Technology-for-the-Poorest-Billion/2024-ideabatic-smirk/README.md

# Project to miniaturise Smile by Ideabatic

## Introduction to project

## Initial aims of the project

## Market research

## Redefined aims of project

## Low fidelity thermal analysis

## Detailed thermal analysis

## Ice pack chamber design and prototyping

## Carousel design and prototyping

## Strap design and prototyping

## Final project deliverables
