Technology-for-the-Poorest-Billion/2024-ideabatic-smirk/interim/Market research and Product design sheets.md

We began by talking to Kitty with what she would like us to do. She got
us started on looking into the UK market, and what applications the box
would work on. We looked into the currently available options, but none
of them seemed appropriate. We asked for kittys market research, and
found that typically vaccination travel rounds last for upwards of 5
hours, which is already enough that a medic may not wish to extend this
time further.

We talked to personal connections we know to see if there would be a
smaller personal ice box market, however this also backfired, as most
people in that market would not need their medication cold dor much
longer than a few hours, and can do so with a small box when on holiday
etc.

The conclusion we came to was that the NHS market was no good. We
proposed a second market to Kitty of a third world country where the
journeys are less dangerous than those currently taken, but still
require a lot of vaccinations in one go. We then looked at current large
capacity cold boxes, and how the existing smile addresses those issues.

Market research:

<table style="width:100%;">
<colgroup>
<col style="width: 16%" />
<col style="width: 16%" />
<col style="width: 16%" />
<col style="width: 16%" />
<col style="width: 16%" />
<col style="width: 16%" />
</colgroup>
<thead>
<tr class="header">
<th>Name</th>
<th>Cold time</th>
<th>Price</th>
<th>Capacity</th>
<th>Weight</th>
<th>Notes</th>
</tr>
<tr class="odd">
<th>Versapak:</th>
<th>Up to 30 hours (assuming unopened at room temperature, not 40
degrees outside)</th>
<th><p>35L = 200 (bundle with 5x700 ice packs = 260)</p>
<p>18L = 155</p>
<p>6L = 136</p></th>
<th><p>Internal Capacity: 6 Litres</p>
<p>Weight (Empty): 1.658kg</p>
<p>Medium - 460 x 305 x 255mm</p>
<p>Internal Capacity: 18 Litres</p>
<p>Weight (Empty): 2.151kg</p>
<p>Large - 650 x 380 x 255mm</p>
<p>Internal Capacity: 35 Litres</p>
<p>Weight (Empty): 3.657kg</p></th>
<th>Ice packs 500ml-700ml per, about 5 ice packs</th>
<th><p>Quite expensive, need to look at how many vaccines can fit.</p>
<p>Too large to comfortably carry in any way other than handle, probably
not great for long walks. Current smile improves on: weight, size,
no.vaccines, cold time with only 1 ice pack.</p></th>
</tr>
<tr class="header">
<th>VaccinePorter:</th>
<th>8 hour plus time</th>
<th>£160</th>
<th>2.2L capacity</th>
<th></th>
<th></th>
</tr>
<tr class="odd">
<th><a
href="https://www.corrmed.com/product-page/porta-thermal-20-litre-vaccine-bag-bundle"><u>CorrMed</u></a>:
CorrMed:</th>
<th>7 hour cold time</th>
<th>£261.75Sale Price (350 otherwise)</th>
<th>20L capacity</th>
<th>Comes with 4 seemingly 1L ice packs</th>
<th></th>
</tr>
<tr class="header">
<th></th>
<th></th>
<th></th>
<th></th>
<th></th>
<th></th>
</tr>
</thead>
<tbody>
</tbody>
</table>

Current options… £500 gets you an electric vaccine cooler, so need to
lower the price towards the £200 range. Looking at insulation can be
useful to try and reduce cost, but can let kitty do this as it would be
more involved for the manufacturing process.

All options seem to be just boxes with handles and seem to be very
expensive. Smile does fix this sort of.

<table>
<colgroup>
<col style="width: 10%" />
<col style="width: 15%" />
<col style="width: 20%" />
<col style="width: 14%" />
<col style="width: 26%" />
<col style="width: 11%" />
</colgroup>
<thead>
<tr class="header">
<th>Part</th>
<th>Reason</th>
<th>Improvement</th>
<th>constraints</th>
<th>Adresses what need</th>
<th>Importance</th>
</tr>
<tr class="odd">
<th>Handle</th>
<th><p>Transportable, Need to think of an easy and durable way to
carry</p>
<p>No handle on SMILE, just a rucksack. Quite expensive, and a whole
extra thing to carry</p></th>
<th><p>Could look at different designs.</p>
<p>Satchel style could be comfortable and modular (guitar strap? £2
per)</p>
<p>Backpack has more pieces but would be more comfortable.<br />
Lunchbox strap is easy and cheap but might get difficult after a
while</p></th>
<th>Comfortable for 1-2 hr of walking - if we will wear a backpack then
do we need a handle/is it critical?</th>
<th>Easy to fix, easy to carry, does not add to the cost, and
lightweight (as opposed to a large expensive insulative bag)</th>
<th>Medium-high</th>
</tr>
<tr class="header">
<th>No. Vaccines</th>
<th>Needs to be maximised since the other constraints are already being
met for time. Can always underfill, so need to think of a cheap way to
store more.at least a certain number, or too many will need to be
brought and will no longer be transportable</th>
<th>Could be as simple as making the carousel smaller to fit the 1L
box.<br />
Could look at improving attachment mechanisms to add more vaccines? Or
make it more versatile.<br />
Maybe a sock/strap type thing like in a toolbox to make it really thin
and versatile</th>
<th><p>Maximise</p>
<p>Each vaccine could take 20-30mins. Over one full day (12 hours?)
would need at least 24</p></th>
<th><p>Probably fewer vaccines than SMILE, but will make it more
portable and easier to transport while still having the maximum
utility</p>
<p>Current SMILE has a very large ice pack, and not all slots are always
filled (currently 3 vaccines per section *18 sections).<br />
Smaller journeys will need less vaccines as they would probably be
limited by the number of patients in one day</p></th>
<th>High</th>
</tr>
<tr class="odd">
<th>Time cold</th>
<th><p>Sufficient to fully vaccinate targets. Bottle to be made 1L</p>
<p>Need to account for loss of insulation due to removal of outer bag of
larger SMILE</p></th>
<th><p>1L ice pottle used, so time would be roughly 3 days already. So
can make volume 3x smaller to make it 1 day?</p>
<p>Could also change insulation to be lighter/better</p></th>
<th>At least 1 working day</th>
<th>Keeps vaccines below 8 degrees so they don’t spoil, while still
reducing the overall dimensions. Less than SMILE, but will make it more
portable and easier to transport, also will reduce cost of ice pack, and
weight.</th>
<th>High priority, but will be changed by real world testing, so only
rough estimates at this stage</th>
</tr>
<tr class="header">
<th>Door</th>
<th>Allows access to vaccines whilst still keeping them cool when not in
use. Needs to be wide enough to comfortably load and unload.</th>
<th>SMILE had a very good door - aim to achieve same functionality but
with a simpler design/fewer parts. Might not even need changing.</th>
<th><p>IP55 dust and waterproof.</p>
<p>Needs to be large enough for easy vaccine removal</p></th>
<th>Allows access to vaccines whilst still keeping them cool when not in
use</th>
<th>Low, current design already well thought of</th>
</tr>
<tr class="odd">
<th>Weight</th>
<th>Needs to be transportable so cool box can reach difficult-to-reach
locations, though less rough terrain so can give up SOME rigidity</th>
<th><p>Reduce dimensions since weight only goes down by the cube.</p>
<p>Thin insulation, although insulation is mostly air so limited
effectiveness</p></th>
<th>Under 10kg</th>
<th>Transportable, probably less durable, but enough to withstand
standard use</th>
<th>High</th>
</tr>
<tr class="header">
<th>Ice pack attachment mechanism</th>
<th><p>Ice pack is changing dimensions. So this will need to be
rethought</p>
<p>Needs to stay central to ensure even cooling of vaccines when melting
and shrinking</p></th>
<th><p>Currently held in place quite loosely, with a rubber part on the
cap. Could look at removing that cap and replacing it with foam. Foam
would also mean that if the specific bottle goes out of sale, a slightly
different one could be used.</p>
<p>Change bearing design to a design that can be used with off the shelf
bottle e.g. a flexible ring constraint around bottle base</p></th>
<th>Simple so that it is easy to use and repair - use minimal parts and
materials</th>
<th>Easy to use, while preventing rattling which the current box does
not do. Current part needs a whole rubberised piece so can reduce cost
this way too. Ensures no even distance of ice pack from all
vaccines</th>
<th>Low</th>
</tr>
<tr class="odd">
<th>Shell</th>
<th>Needs to provide a protective, damage resistant layer. Loss of
padding of outer bag means it may been to be more durable/waterproof and
incorporate carrying mechanism</th>
<th>May not need much improvement, but new materials and manufacturing
methods could be considered to reduce cost of product. May need to be
changed to be more comfortable to carry against body without the outer
padding</th>
<th><p>Minimum number of parts for repair.</p>
<p>IP55 dust and waterproof.</p></th>
<th>Protective outer shell providing waterproofing and rigidity</th>
<th>Low, current design already well thought out</th>
</tr>
<tr class="header">
<th>Vaccine recording method</th>
<th>Vaccine organisation charts will increase efficiency of vaccine use
and delivery.</th>
<th>This needs to be integrated into the hard shell somehow, if the
outer bag is not being used. Easily changed vaccine labelling system or
a slot for this should be included</th>
<th>Cannot affect waterproofing, should not change mass of product or
make it more bulky. Ease of use and accessible</th>
<th>Allows health worker to keep track of vaccines being delivered and
their location in the cooler. Reduces need to expose all vaccines to
heat whilst searching manually</th>
<th>High</th>
</tr>
</thead>
<tbody>
</tbody>
</table>

[<u>https://www.greenspec.co.uk/building-design/insulation-materials-thermal-properties/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,%3B%200.038%20%2D%200.040%20in%20walls</u>](https://www.greenspec.co.uk/building-design/insulation-materials-thermal-properties/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,%3B%200.038%20%2D%200.040%20in%20walls).
