Technology-for-the-Poorest-Billion/2024-ideabatic-smirk/www/market_research.md

---
title: Market Research
---
<sup>Article by Caio Bezerra</sup>

We began by talking to Kitty with what she would like us to do. She got
us started on looking into the UK market, and what applications the box
would work on. We looked into the potential options, but none
of them seemed appropriate. We asked for kittys market research, and
found that typically vaccination travel rounds last for upwards of 5
hours, which is already enough that a medic may not wish to extend this
time further. There was also a lack of people in a position of buying power to ask futher questions with meaningful answers.

We then talked to personal connections we know to see if there would be a
smaller personal ice box market, however this also backfired, as most
people in that market would not need their medication cold or much
longer than a few hours, and can do so with a small box when on holiday
etc. We even looked at a potential vet market as they must travel large distances to rural farms with their vaccines.

The conclusion we came to was that the NHS and personal markets were no good. We
proposed a second market to Kitty of a third world country where the
journeys are less dangerous than those currently taken, but still
require a lot of vaccinations in one go. We then looked at current large
capacity cold boxes, and how the existing smile addresses those issues. This led us to conclude that shrinking the smile would be viable for such a market, but some key constraints applied that would be different to a box in the west.

Market research:

<table style="width:100%;">
<colgroup>
<col style="width: 16%" />
<col style="width: 16%" />
<col style="width: 16%" />
<col style="width: 16%" />
<col style="width: 16%" />
<col style="width: 16%" />
</colgroup>
<thead>
<tr class="header">
<th>Name</th>
<th>Cold time</th>
<th>Price</th>
<th>Capacity</th>
<th>Weight</th>
<th>Notes</th>
</tr>
<tr class="odd">
<th>Versapak:</th>
<th>Up to 30 hours (assuming unopened at room temperature, not 40
degrees outside)</th>
<th><p>35L = 200 (bundle with 5x700 ice packs = 260)</p>
<p>18L = 155</p>
<p>6L = 136</p></th>
<th><p>Large - 650 x 380 x 255mm</p>
<p>Internal Capacity: 35 Litres</p>
<p>Weight (Empty): 3.657kg</p></th>
<th>Ice packs 500ml-700ml per, about 5 ice packs to be fit, reduces capacit</th>
<th><p>Quite expensive, inefficient vaccine storage as they must be held otherwise they will be loose.</p>
<p>Too large to comfortably carry in any way other than handle,
not great for long walks. Current smile improves on: weight, size,
no.vaccines, cold time with only 1 ice pack. Advantages are that it is ~40% the cost of a smile. </p></th>
</tr>
<tr class="header">
<th>VaccinePorter:</th>
<th>8 hours plus</th>
<th>£160</th>
<th>2.2L capacity</th>
<th>N/A</th>
<th>Quite expensive and small especially when compared to the Versapak</th>
</tr>
<tr class="odd">
<th><a
href="https://www.corrmed.com/product-page/porta-thermal-20-litre-vaccine-bag-bundle"><u>CorrMed</u></a>:
</th>
<th>7 hour cold time</th>
<th>£261.75 Sale Price (350 otherwise)</th>
<th>20L capacity</th>
<th>Comes with 4 seemingly 1L ice packs, which adds 4KG and reduces internal capacity to 16L</th>
<th>Good alternative to Versapak, and is also reasonably priced with extras. Rated cold time not fantastic, and size is also a large concern</th>
</tr>
<tr class="header">
<th>SMILE Vaccine Carrier</th>
<th>5 Day Cold Time</th>
<th><p>$66.18 - Plastic</p>
<p>$60 - Backpack</p>
<p>$19.7688 - Screws, Ball bearing, Spring</p>
<p>$48 - Icepack (replaced with one that costs $5</p>
<p>267.5502 - CNC PIR (could potenrially be heavily reduced)</p>
<p> 461.5 </p>
<p>All prices for an order quantity of £3000 </p>
</th>
<th>36-54 vaccines depending on sizes</th>
<th> NEED TO MEASURE TMRW</th>
<th>Very expensive compared to otehr options, Unsure how many vaccines currently fit in others per L capacity, but the cold time is probably a much stronger limiting factor, as you wouldnt be able to use them all in one 24 hour period</th>
</tr>
</thead>
<tbody>
</tbody>
</table>

Current options seem to be worse than the smile in almost every way. The SMILE, although more expensive, seems to be much more valuable for the money, giving a very clear market edge. All options seem to be just boxes with handles and seem to be very expensive. This could be due to them not being designed for being carried, but the core specifications are also not very appealing for the market. The alternatives are also quite limited, as the same few companies seem to show up frequently, so some competitive diversity in the market for mid sized Vaccine carriers would not do badly.

Though the smile may be slightly more hassle to load and unload due to the small opening, you cannot argue that it is less effective. For the goal we are aiming for, the number of vaccines and cold time may be quite overkill, and so looking at making sensible cuts will hopefully drastically cut the cost, allowing us to make one which is competitive in the market costwise, and can slot into hospitals which already use the smile well with the modularity we are aiming for.
