Technology-for-the-Poorest-Billion/2024-ideabatic-smirk/www/ice_chamber_code_slash_maths.md

---
title: Ice chamber Code/Maths/design
---
