Technology-for-the-Poorest-Billion/2024-ideabatic-smirk/www/Daniel/Strap_Research.md

## Strap Research

#### Requirements

Functions the straps **must** perform:
* Carry the weight of the Miniature Smile >2kg
* Adjust to fit body size
* Not significantly increase weight of Smile
  * Should not weigth more than the current backpack design for the larger Smile
* Be padded to provide comfortable fit for health worker
* Have strong attatchments to Smile box
  
Functions the straps **could** perform:
* Provide option for shoulder carrying
* Provide option for backpack carrying
* Have ability to fit larger smile by same attatchments
* could carry the weight of the large Smile >3.5kg
* Integrate vaccine recording cards

#### Conventional Rucksack-style Straps

This is similar to the type of strap that was initially prototyped and featured in the interim presentation. A photo is included below:



The major difference between this strap and the one prototyped is that this strap would wrap around so that both sides would be attached to the Smile's body. This would mean that it could be carried hands-free as the wearer's hands aren't required to keep the box and straps in place. This strap is evaluated below:

Would fulfill:
* Carry the weight of the Miniature Smile >2kg
* Adjust to fit body size
* Have strong attatchments to Smile box
* Provide option for backpack carrying
* Should carry the weight of the large Smile >3.5kg
* Not significantly increase weight of Smile
  * Should not weigth more than the current backpack design for the larger Smile

Would be challenging to fulfill:

* Be padded to provide comfortable fit for health worker
* Provide option for shoulder carrying
* Have ability to fit larger smile by same attatchments
* Integrate vaccine recording cards

This idea is of the more conventional type, which means that there should be lots of widely-available information on it's design and how it could be manufactured. This is a solid proposal and very similar to the one the group last year researched.

#### Guitar Strap

Guitars typically weigh 2-3 kg and so the straps used to carry them are first investigated. Guitar straps are typically mounted over one shoulder only, as shown below:



The Miniature Smile could be carried in a similar way. Below is a review of how well this type of strap fulfills the objectives:

Would fulfill:
* Carry the weight of the Miniature Smile >2kg
* Not significantly increase weight of Smile
  * Should not weigth more than the current backpack design for the larger Smile
* Provide option for single-shoulder carrying
* Have ability to fit larger Smile by same attatchments

Would be challenging to fulfill:
* Adjust to fit body size
* Be padded to provide comfortable fit for health worker
* Have strong attatchments to smile box
* Provide option for backpack carrying
* could carry the weight of the large Smile >3.5kg
* Integrate vaccine recording cards

Overall this mounting idea is simple to execute, however there would be a lot of challenges with getting it to fulfill all of the criteria.

#### Drum Strap

If the Miniature Smile is to be front mounted, a strap similar to that used to carry snare drums on parades could be used. An example of this is shown below:



A strap like this would fulfill the following requirements:

Would fulfill:
* Carry the weight of the Miniature Smile >2kg
* Adjust to fit body size
* Not significantly increase weight of Smile
  * Should not weigth more than the current backpack design for the larger Smile

Would be challenging to fulfill:
* Be padded to provide comfortable fit for health worker
* Have strong attatchments to Smile box
* Provide option for single-shoulder carrying
* Provide option for backpack carrying
* Have ability to fit larger smile by same attatchments
* Could carry the weight of the large Smile >3.5kg
* Integrate vaccine recording cards

Although this idea initially seemed promising due to the similarities with a conventional rucksack with mounting straps over both shoulders, after evaluating against the requirements this idea performs poorly and should be discarded.

#### Suitcase Shoulder Straps

A shoulder strap system is available for suitcases whereby the suitcase is strapped to backpack-style straps and mounted on the user's back like a normal backpack. An image of such a system is included below:



This is evaluated below:

Would fulfill:
* Carry the weight of the Miniature Smile >2kg
* Adjust to fit body size
* Not significantly increase weight of Smile
  * Should not weigth more than the current backpack design for the larger Smile
* Be padded to provide comfortable fit for health worker
* Have strong attatchments to Smile box
* Provide option for backpack carrying
* Have ability to fit larger smile by same attatchments
* could carry the weight of the large Smile >3.5kg
* Integrate vaccine recording cards

Would be challenging to fulfill:
* Provide option for single-shoulder carrying

This is the most promising idea by far and as such it is the one with which we'll proceed. Both the original and the Miniature Smile could be carried by these same set of straps, with adjustable fastening straps to fit hexagons of different sizes.

This design has been prototyped and is shown below for the prototype Miniature Smile:





EVERYTHING BELOW HERE ARE NOTES

Move all photos into www photo so appear on webpage

Edit index page so all my pages are linked and written about in website

Use laser cutter to produce some mechanism prototype

Make prototype for hegaxon aligned vertically as per the new proposed Smile idea

Investigate 2L Water backpacks
Flight suit record card pocket
Straps for carrying musical instrument cases - could be off the shelf to reduce manufacturing costs

Come up with strap design concepts and produce sketches bearing in mind ergonomics, mounting & modularity.
Make prototype.

Consider over the shoulder strap instead of backpack

Take a look at last year's work for strap stuff - don't repeat - Kitty's Drive: https://drive.google.com/drive/folders/12QNKav0X3rGFk-dYRm6YgCxjDsl4oQKn?usp=sharing

Goal: Come up with different strap mounting mechanisms and produce rough 3D model/drawings then prototype. Be inspired by pre-existing designs such as guitar case mounting/cello case mounting etc. The problem with the current one is that it is too sharp and will dig into back.

Potentially ways to include storage pouch and vaccine recording sheet pouch in bag strap

Find things already out there for straps. Camelbaks for 2L water for example (already done for that weight)

Things to attach suitcase to back pack - also a thick shell.

Maybe make a market-research-type table to decide what needs to be bought/modified/strap attachment etc.

* Carry the weight of the Miniature Smile >2kg
* Adjust to fit body size
* Not significantly increase weight of Smile
  * Should not weigth more than the current backpack design for the larger Smile
* Be padded to provide comfortable fit for health worker
* Have strong attatchments to Smile box
* Provide option for shoulder carrying
* Provide option for backpack carrying
* Have ability to fit larger smile by same attatchments
* could carry the weight of the large Smile >3.5kg
* Integrate vaccine recording cards
