Technology-for-the-Poorest-Billion/2024-ideabatic-smirk/interim/meeting notes/Dan Planning.md

# Dan Planning

Do straps research section in www folder

Record group presentation

Polish up text on my part of the website and whole website

Submit!!
