Technology-for-the-Poorest-Billion/2024-ideabatic-smirk/www/landing-page/WhatsApp Image 2024-06-05 at 17.23.50 (1).jpeg

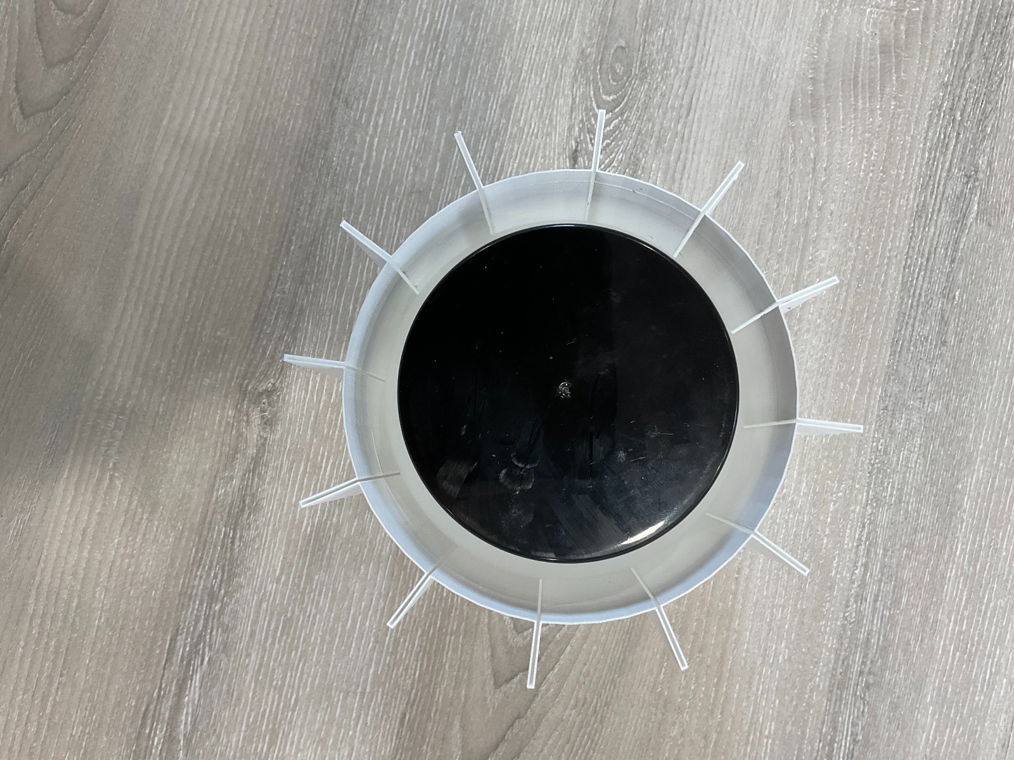
www/landing-page/WhatsApp Image 2024-06-05 at 17.23.50 (1).jpeg
