Technology-for-the-Poorest-Billion/2024-ideabatic-smirk/www/Photos/Big_radial.png

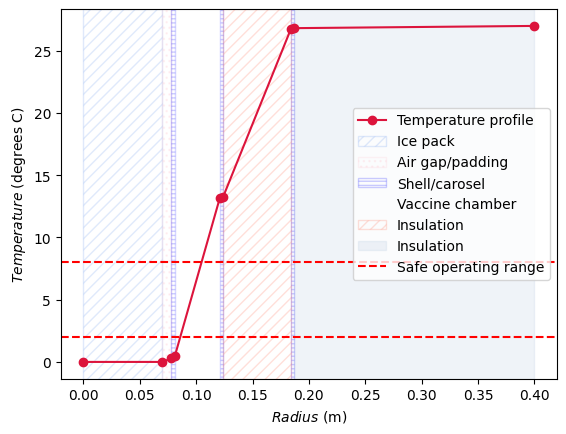
www/Photos/Big_radial.png
