Technology-for-the-Poorest-Billion/2024-ideabatic-smirk/www/Photos/foam-empty.jpeg

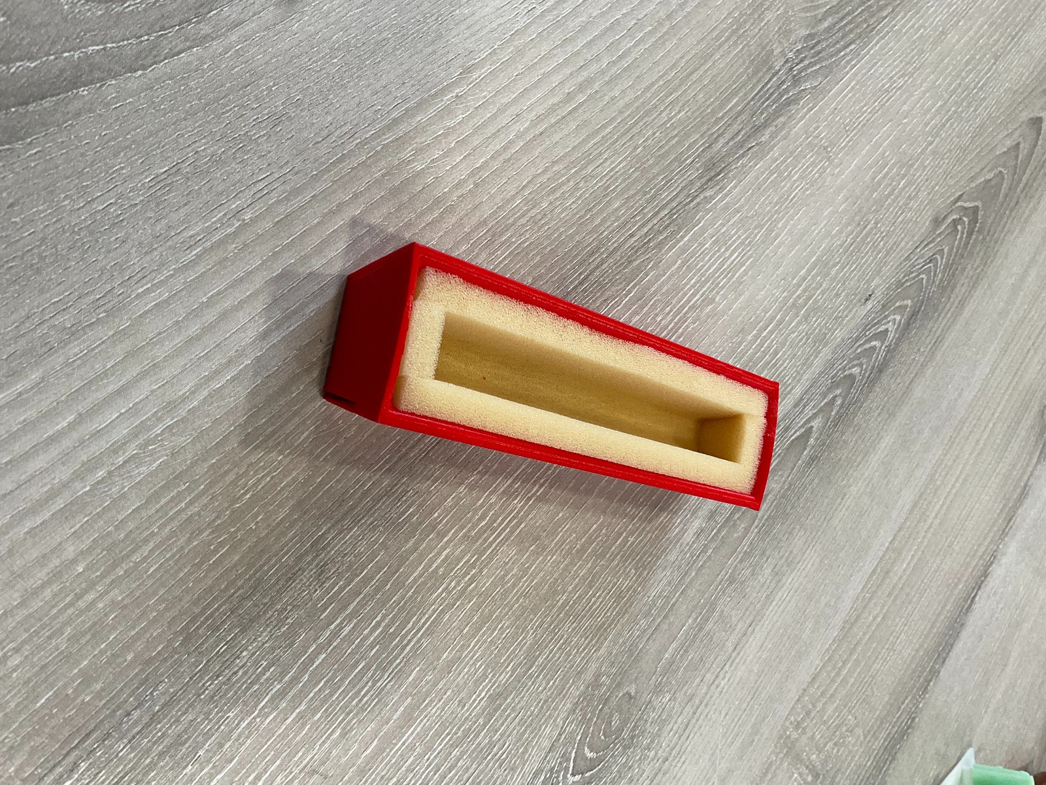
www/Photos/foam-empty.jpeg
