Technology-for-the-Poorest-Billion/2024-ideabatic-smirk/www/Photos/Linear_resistor _network.png

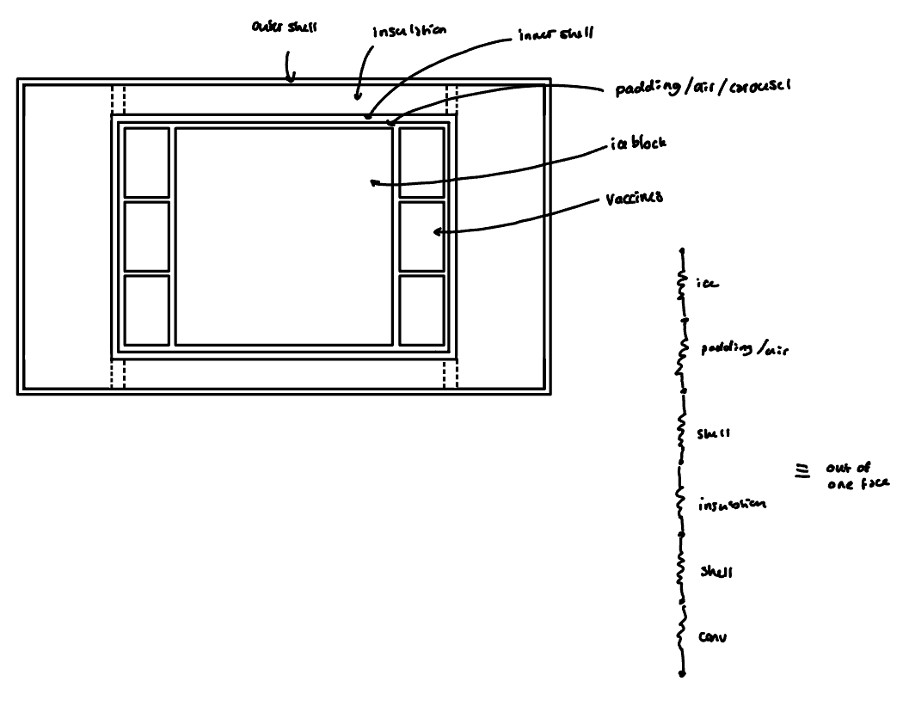
www/Photos/Linear_resistor _network.png
