Technology-for-the-Poorest-Billion/2024-ideabatic-smirk/www/Photos/puzzle-front.jpeg

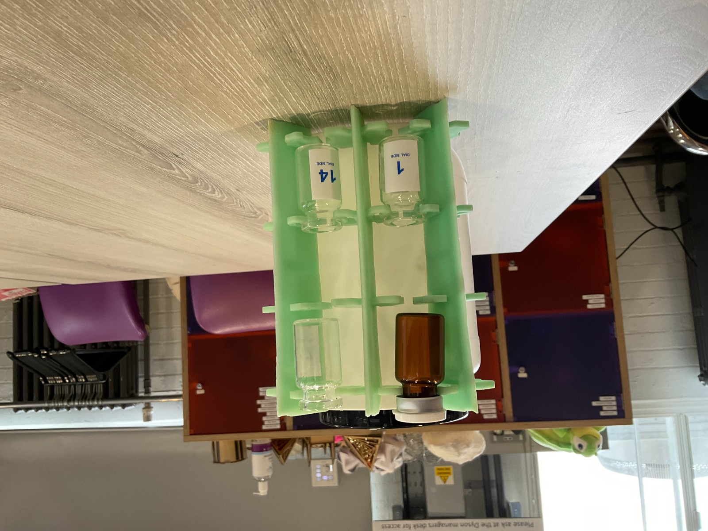
www/Photos/puzzle-front.jpeg
