Technology-for-the-Poorest-Billion/2024-ideabatic-smirk/www/Photos/puzzle-loaded.jpeg

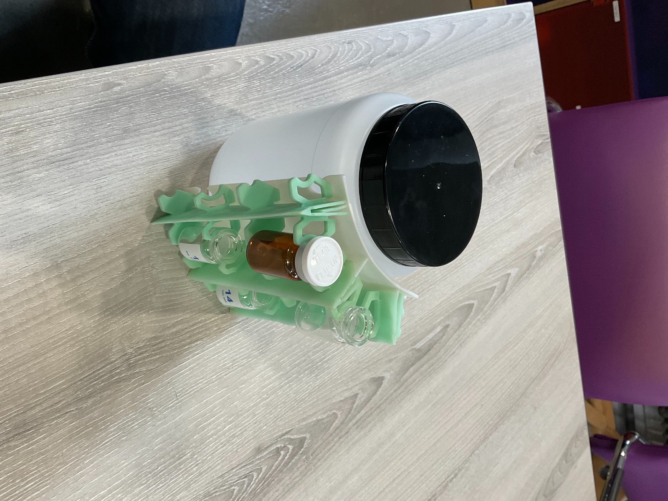
www/Photos/puzzle-loaded.jpeg
