Technology-for-the-Poorest-Billion/2024-ideabatic-smirk/www/Photos/Screenshot_20240605_230309_Samsung Notes.jpg

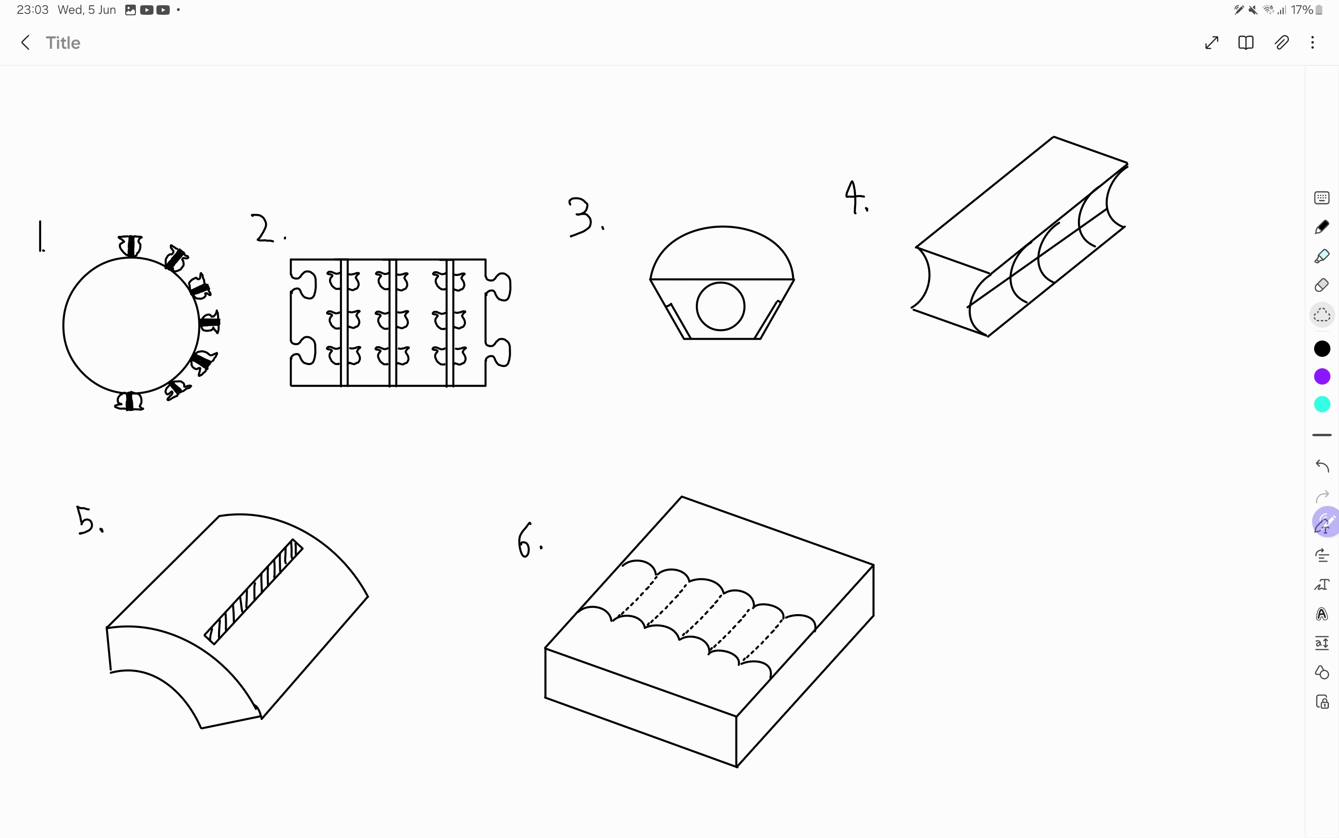
www/Photos/Screenshot_20240605_230309_Samsung Notes.jpg
