Technology-for-the-Poorest-Billion/2024-ideabatic-smirk/www/Photos/straps-side-on.jpeg

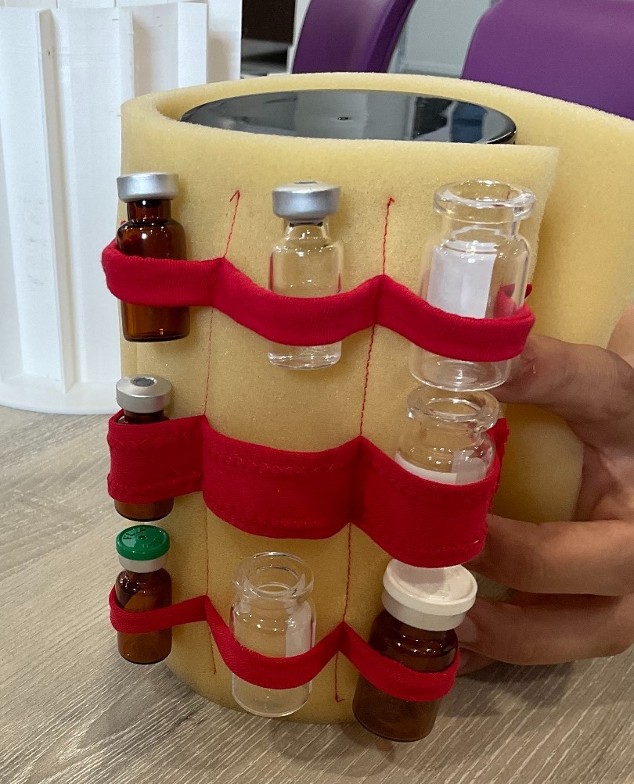
www/Photos/straps-side-on.jpeg
