Technology-for-the-Poorest-Billion/2024-ideabatic-smirk/www/Photos/ToBeDeleted1.jpg

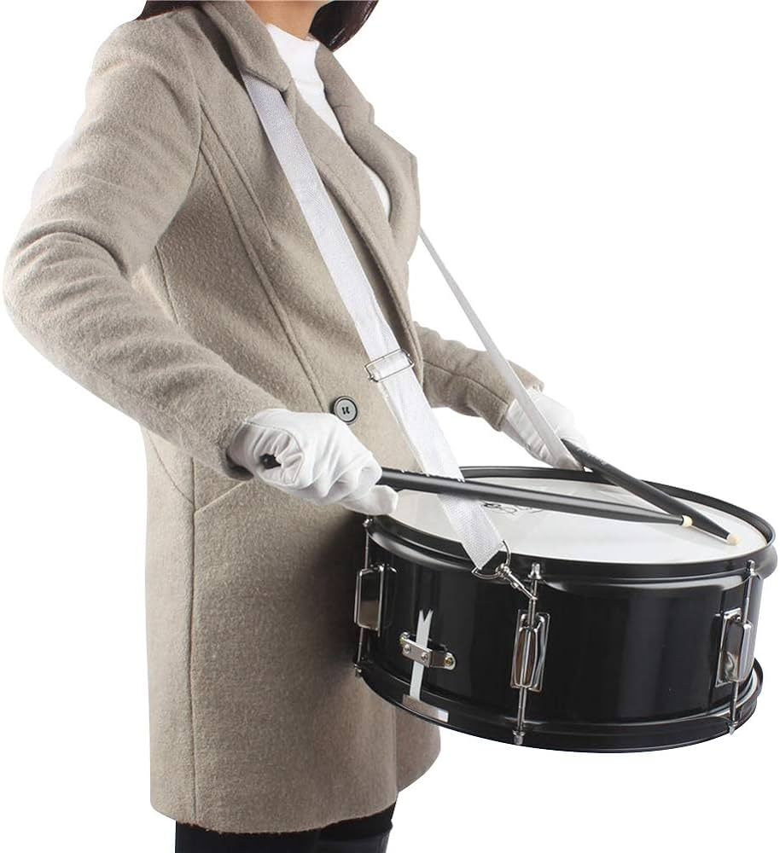
www/Photos/ToBeDeleted1.jpg
