Technology-for-the-Poorest-Billion/2024-ideabatic-smirk/www/Compartment 2.STL

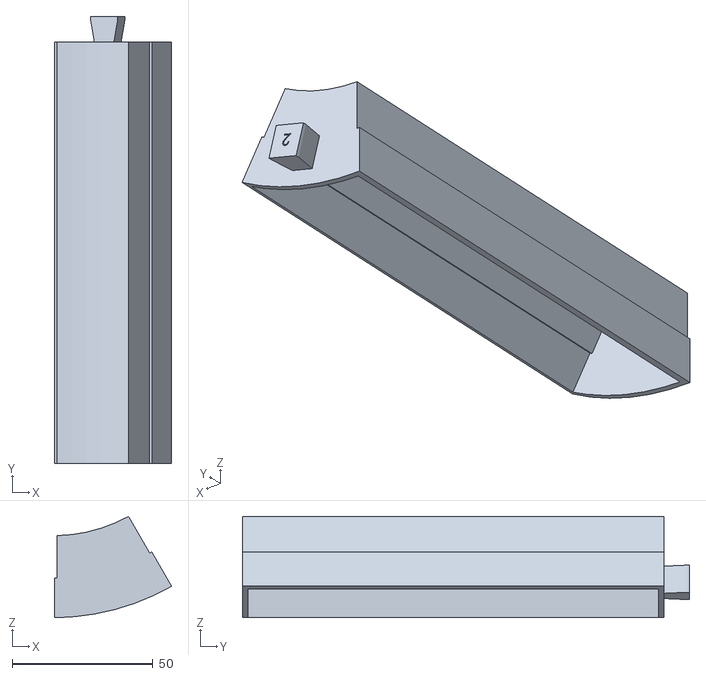
[picture p112: CAD file, 2024-06-06]
www/Compartment 2.STL
41.7 x 159.0 x 36.0
