Technology-for-the-Poorest-Billion/2024-ideabatic-smirk/www/insert cap.STL

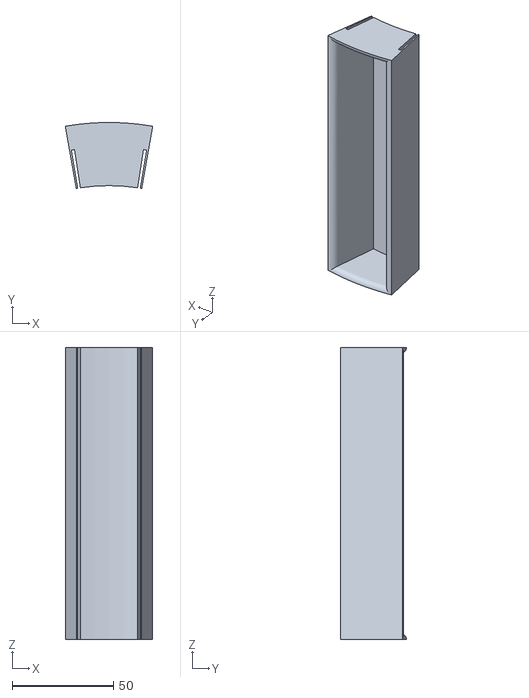
[picture p113: CAD file, 2024-06-06]
www/insert cap.STL
43.1 x 32.5 x 144.0
