Technology-for-the-Poorest-Billion/2024-ideabatic-smirk/(list of files, cad)

Other CAD files:
www/Compartment 3.STL
www/Compartment 1.STL
