Technology-for-the-Poorest-Billion/2024-ideabatic-smirk/(commit log)

2024-05-24 Create Strap Design
2024-05-24 Rename Strap Design to Strap Design.md
2024-05-24 Update Strap Design.md
2024-05-24 Rename Strap Design.md to Dan Strap Design.md
2024-05-24 Update Dan Strap Design.md
2024-05-25 Insert images in markdown
2024-05-26 Create Temperature analysis
2024-05-26 Update Temperature analysis
2024-05-26 Create Temperature analysis.md
2024-05-26 Update Temperature analysis.md
2024-05-27 Rename Linear resistor network.jpg to Linear_resistor_network.jpg
2024-05-27 Rename Radial resistor network.jpg to Radial_resistor_network.jpg
2024-05-30 Rename Strap Design to Livvy Strap Design.md
2024-05-30 Update Livvy Strap Design.md
2024-06-02 Create Ice Chamber CodeslashMaths
2024-06-02 Rename Ice Chamber CodeslashMaths to ice_chamber_code_slash_maths.md
2024-06-03 Create strap_design
2024-06-05 Rename Temperature analysis.md to temperature-analysis.md
2024-06-05 Update and rename Strap_Design.md to Initial_Strap_Prototype.md
