Technology-for-the-Poorest-Billion/2024-ideabatic-smirk/interim/IMG_3840.jpeg

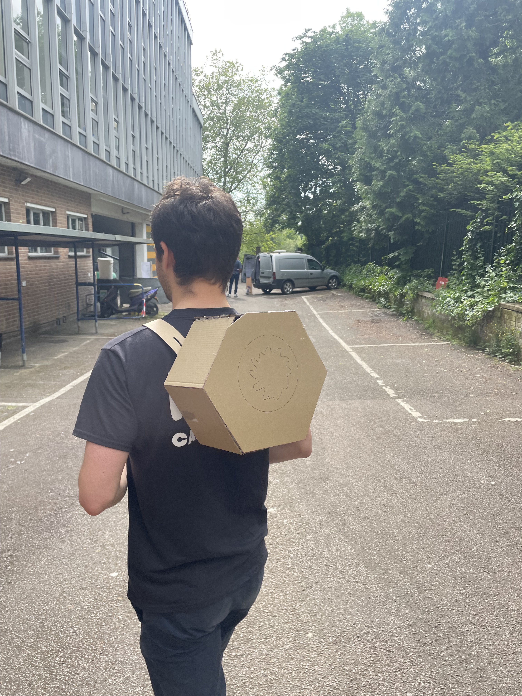
[picture p22: interim/photographs/IMG_3840.jpeg]
interim/IMG_3840.jpeg
